seanboe/Onyx_PDB/README.md

# Onyx Power Distribution Board 

See the updated project in [Team Inspiration's Repository](https://github.com/InspirationRobotics/PowerDist).
