seanboe/Onyx_PDB/1.0/1.0-drl_map.dxf

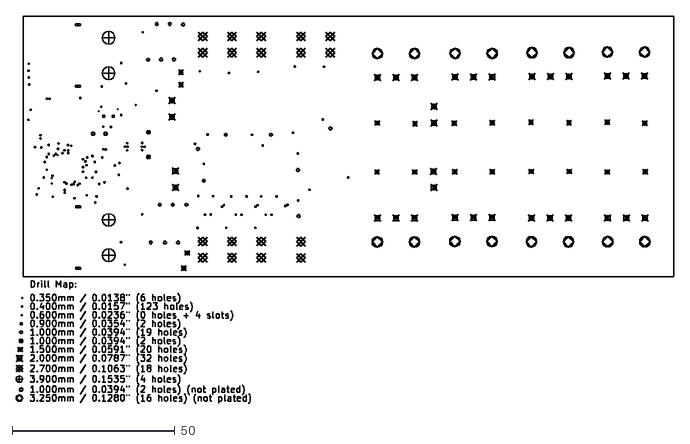
[picture p1: CAD file, 2023-02-26]
1.0/1.0-drl_map.dxf
202.1 x 118.9
