seanboe/Onyx_PDB/1.1/esc/hot_swap_3dmodels/BESC30-R3.step

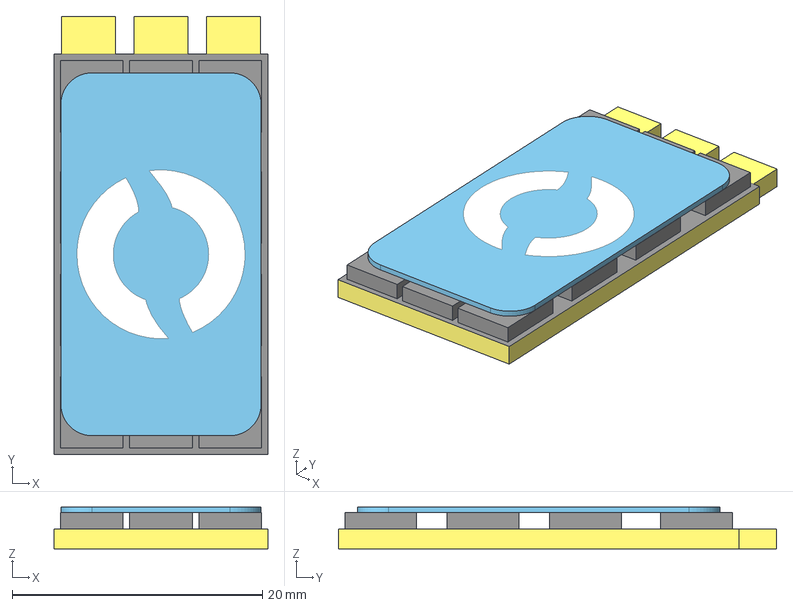
[picture p2: CAD file, 2023-02-10]
1.1/esc/hot_swap_3dmodels/BESC30-R3.step
17.1 x 35.0 x 3.35 mm
BASICESC-G-PCB-X1
BASICESC-E-MOSFET x 12
BASICESC-M-HEAT-SPREADER-X1
