seanboe/Onyx_PDB/1.1/main/gerbers/1.0-drl_map.dxf

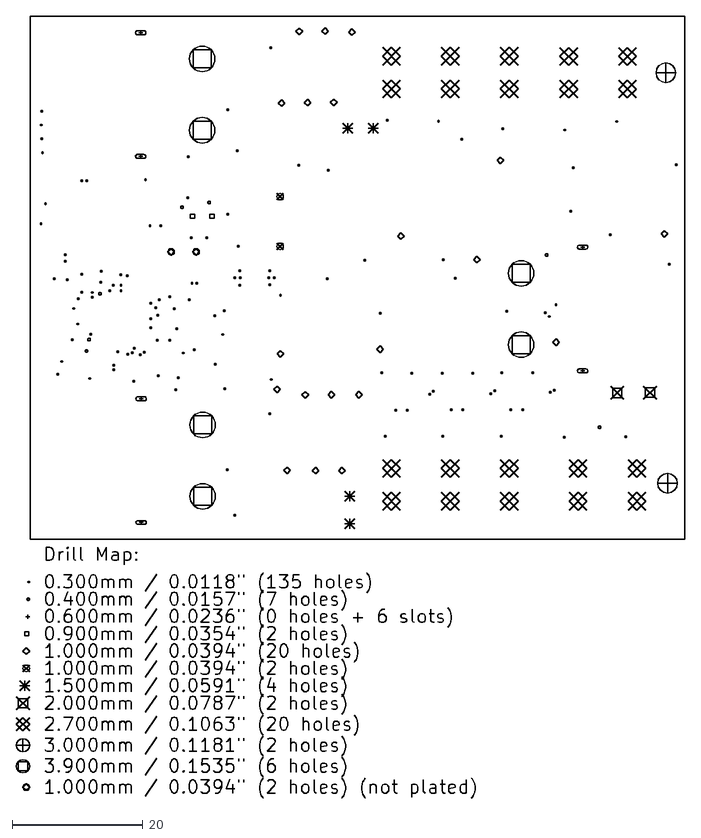
[picture p3: CAD file, 2023-06-17]
1.1/main/gerbers/1.0-drl_map.dxf
102.1 x 119.5
