seanboe/Onyx_PDB/mosfet_breakout_1.0/gerbers/mosfet_breakout_1.0-drl_map.dxf

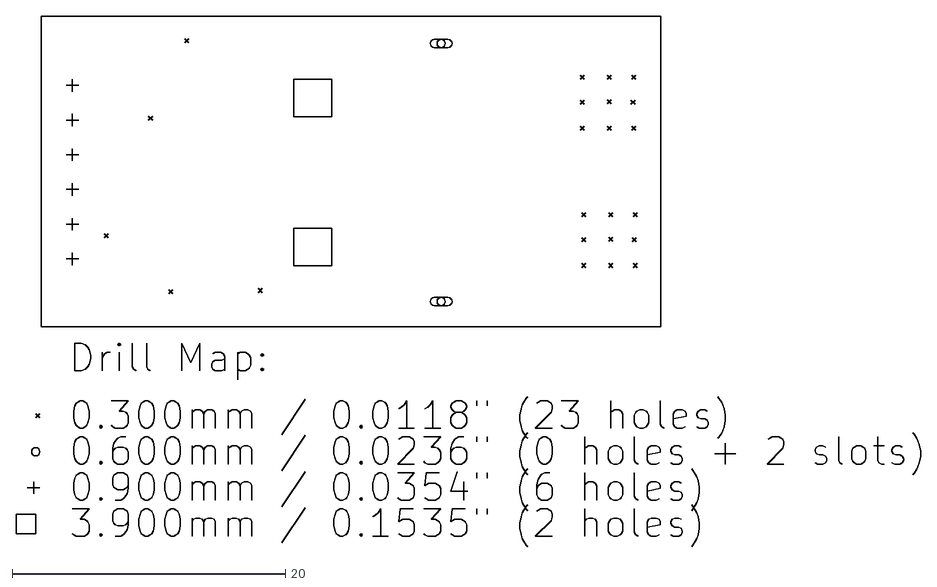
[picture p5: CAD file, 2023-06-17]
mosfet_breakout_1.0/gerbers/mosfet_breakout_1.0-drl_map.dxf
66.2 x 38.8
