seanboe/Onyx_PDB/1.1/main/1.0.kicad_pcb

## KiCad design 1.1/main/1.0.kicad_pcb (2023-06-17)

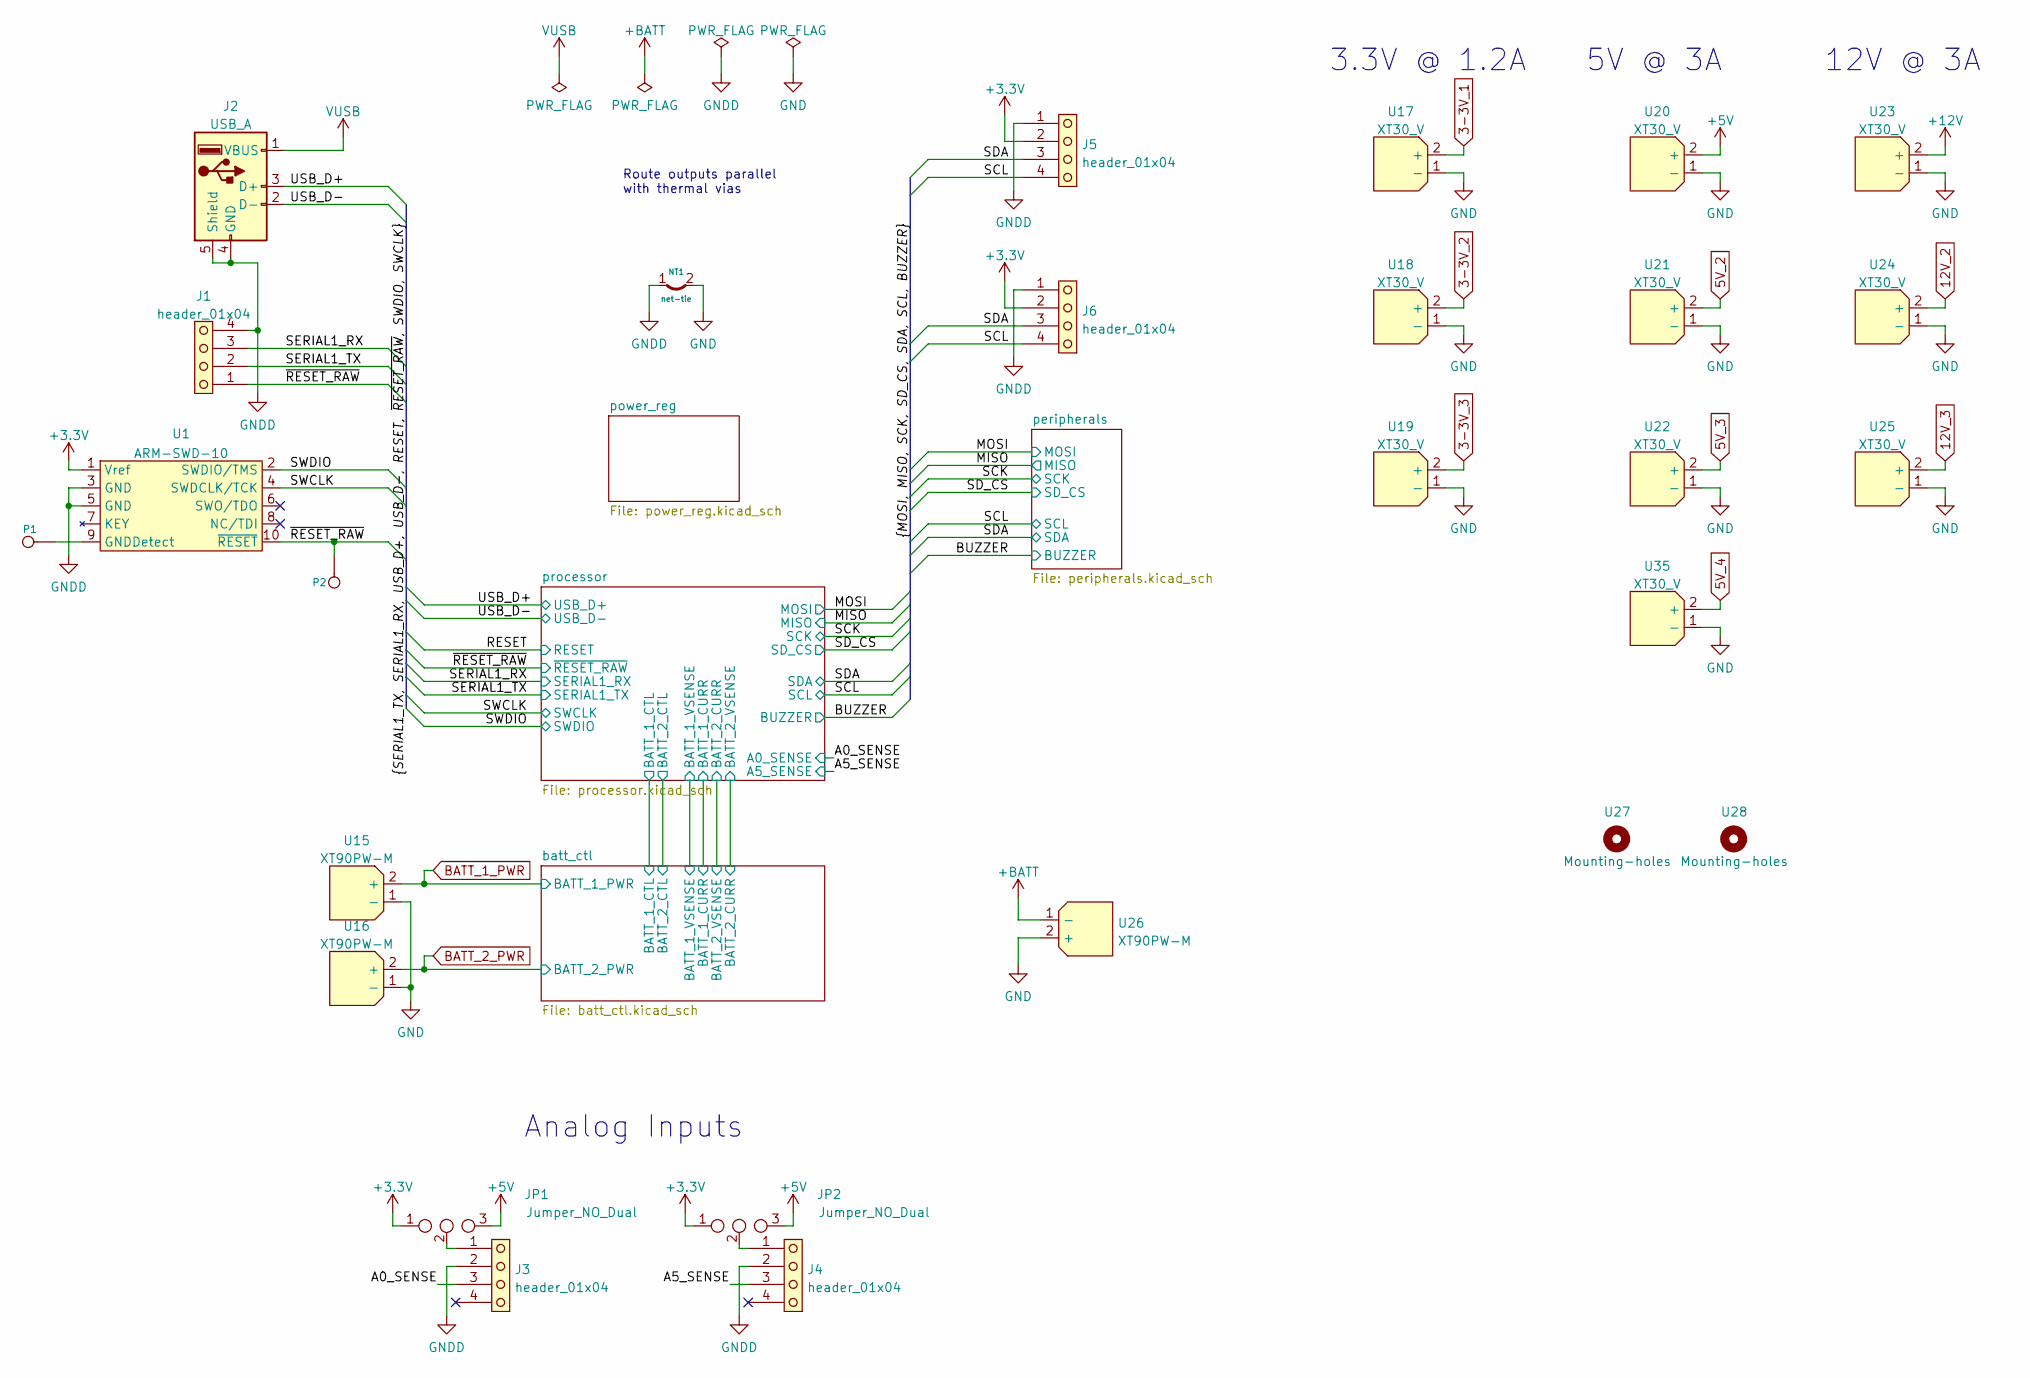
[picture p6: schematic 1.0.kicad_sch, Onyx Unified Power Control Board]

Parts:
J1: header_01x04; Stemma_QT_V
J2: USB_A; amphenol_micro_usb_no_flange_10118192
J3, J4, J5, J6: header_01x04; Stemma_QT_2
JP1, JP2: Jumper_NO_Dual; SolderJumper-3_P1.3mm_Open_RoundedPad1.0x1.5mm_NumberLabels
NT1: net-tie; NetTie-2_SMD_Pad2.0mm
P1, P2: CONN_1; header_01x01_tht
U1: ARM-SWD-10
U15, U16, U26: XT90PW-M; AMASS_XT90PW-M_Horizontal
U17, U18, U19, U20, U21, U22, U23, U24, U25, U35: XT30_V; AMASS_XT30U-F_1x02_P5.0mm_Vertical
U27, U28: Mounting-holes; plated_hole_3.0x3.6mm

Connections:
3-3V_1: U17.2 (+); also elsewhere on the board
3-3V_2: U18.2 (+); also elsewhere on the board
3-3V_3: U19.2 (+); also elsewhere on the board
5V_2: U21.2 (+); also elsewhere on the board
5V_3: U22.2 (+); also elsewhere on the board
12V_2: U24.2 (+); also elsewhere on the board
12V_3: U25.2 (+); also elsewhere on the board
+3V3: J5.2, J6.2, JP1.1, JP2.1, U1.1 (Vref); also elsewhere on the board
+5V: JP1.3, JP2.3, U20.2 (+); also elsewhere on the board
+12V: U23.2 (+); also elsewhere on the board
+BATT: U26.1 (-); also elsewhere on the board
/A0_SENSE: J3.3; also elsewhere on the board
/A5_SENSE: J4.3; also elsewhere on the board
/SCL: J5.4, J6.4; also elsewhere on the board
/SDA: J5.3, J6.3; also elsewhere on the board
/SERIAL1_RX: J1.3; also elsewhere on the board
/SERIAL1_TX: J1.2; also elsewhere on the board
/SWCLK: U1.4 (SWDCLK/TCK); also elsewhere on the board
/SWDIO: U1.2 (SWDIO/TMS); also elsewhere on the board
/USB_D+: J2.3 (D+); also elsewhere on the board
/USB_D-: J2.2 (D-); also elsewhere on the board
/~RESET_RAW: J1.1, P2.1, U1.10 (~RESET); also elsewhere on the board
BATT_1_PWR: U15.2 (+); also elsewhere on the board
BATT_2_PWR: U16.2 (+); also elsewhere on the board
GND: NT1.2, U15.1 (-), U16.1 (-), U17.1 (-), U18.1 (-), U19.1 (-), U20.1 (-), U21.1 (-), U22.1 (-), U23.1 (-), U24.1 (-), U25.1 (-), U26.2 (+), U35.1 (-); also elsewhere on the board
GNDD: J1.4, J2.4 (GND), J2.5 (Shield), J3.2, J4.2, J5.1, J6.1, NT1.1, U1.3 (GND), U1.5 (GND); also elsewhere on the board
unnamed: J3.1, JP1.2
unnamed: J4.1, JP2.2
unnamed: P1.1, U1.9 (GNDDetect)
VUSB: J2.1 (VBUS); also elsewhere on the board

Notes on the sheet:
12V @ 3A
Analog Inputs
Route outputs parallel with thermal vias
3.3V @ 1.2A
5V @ 3A

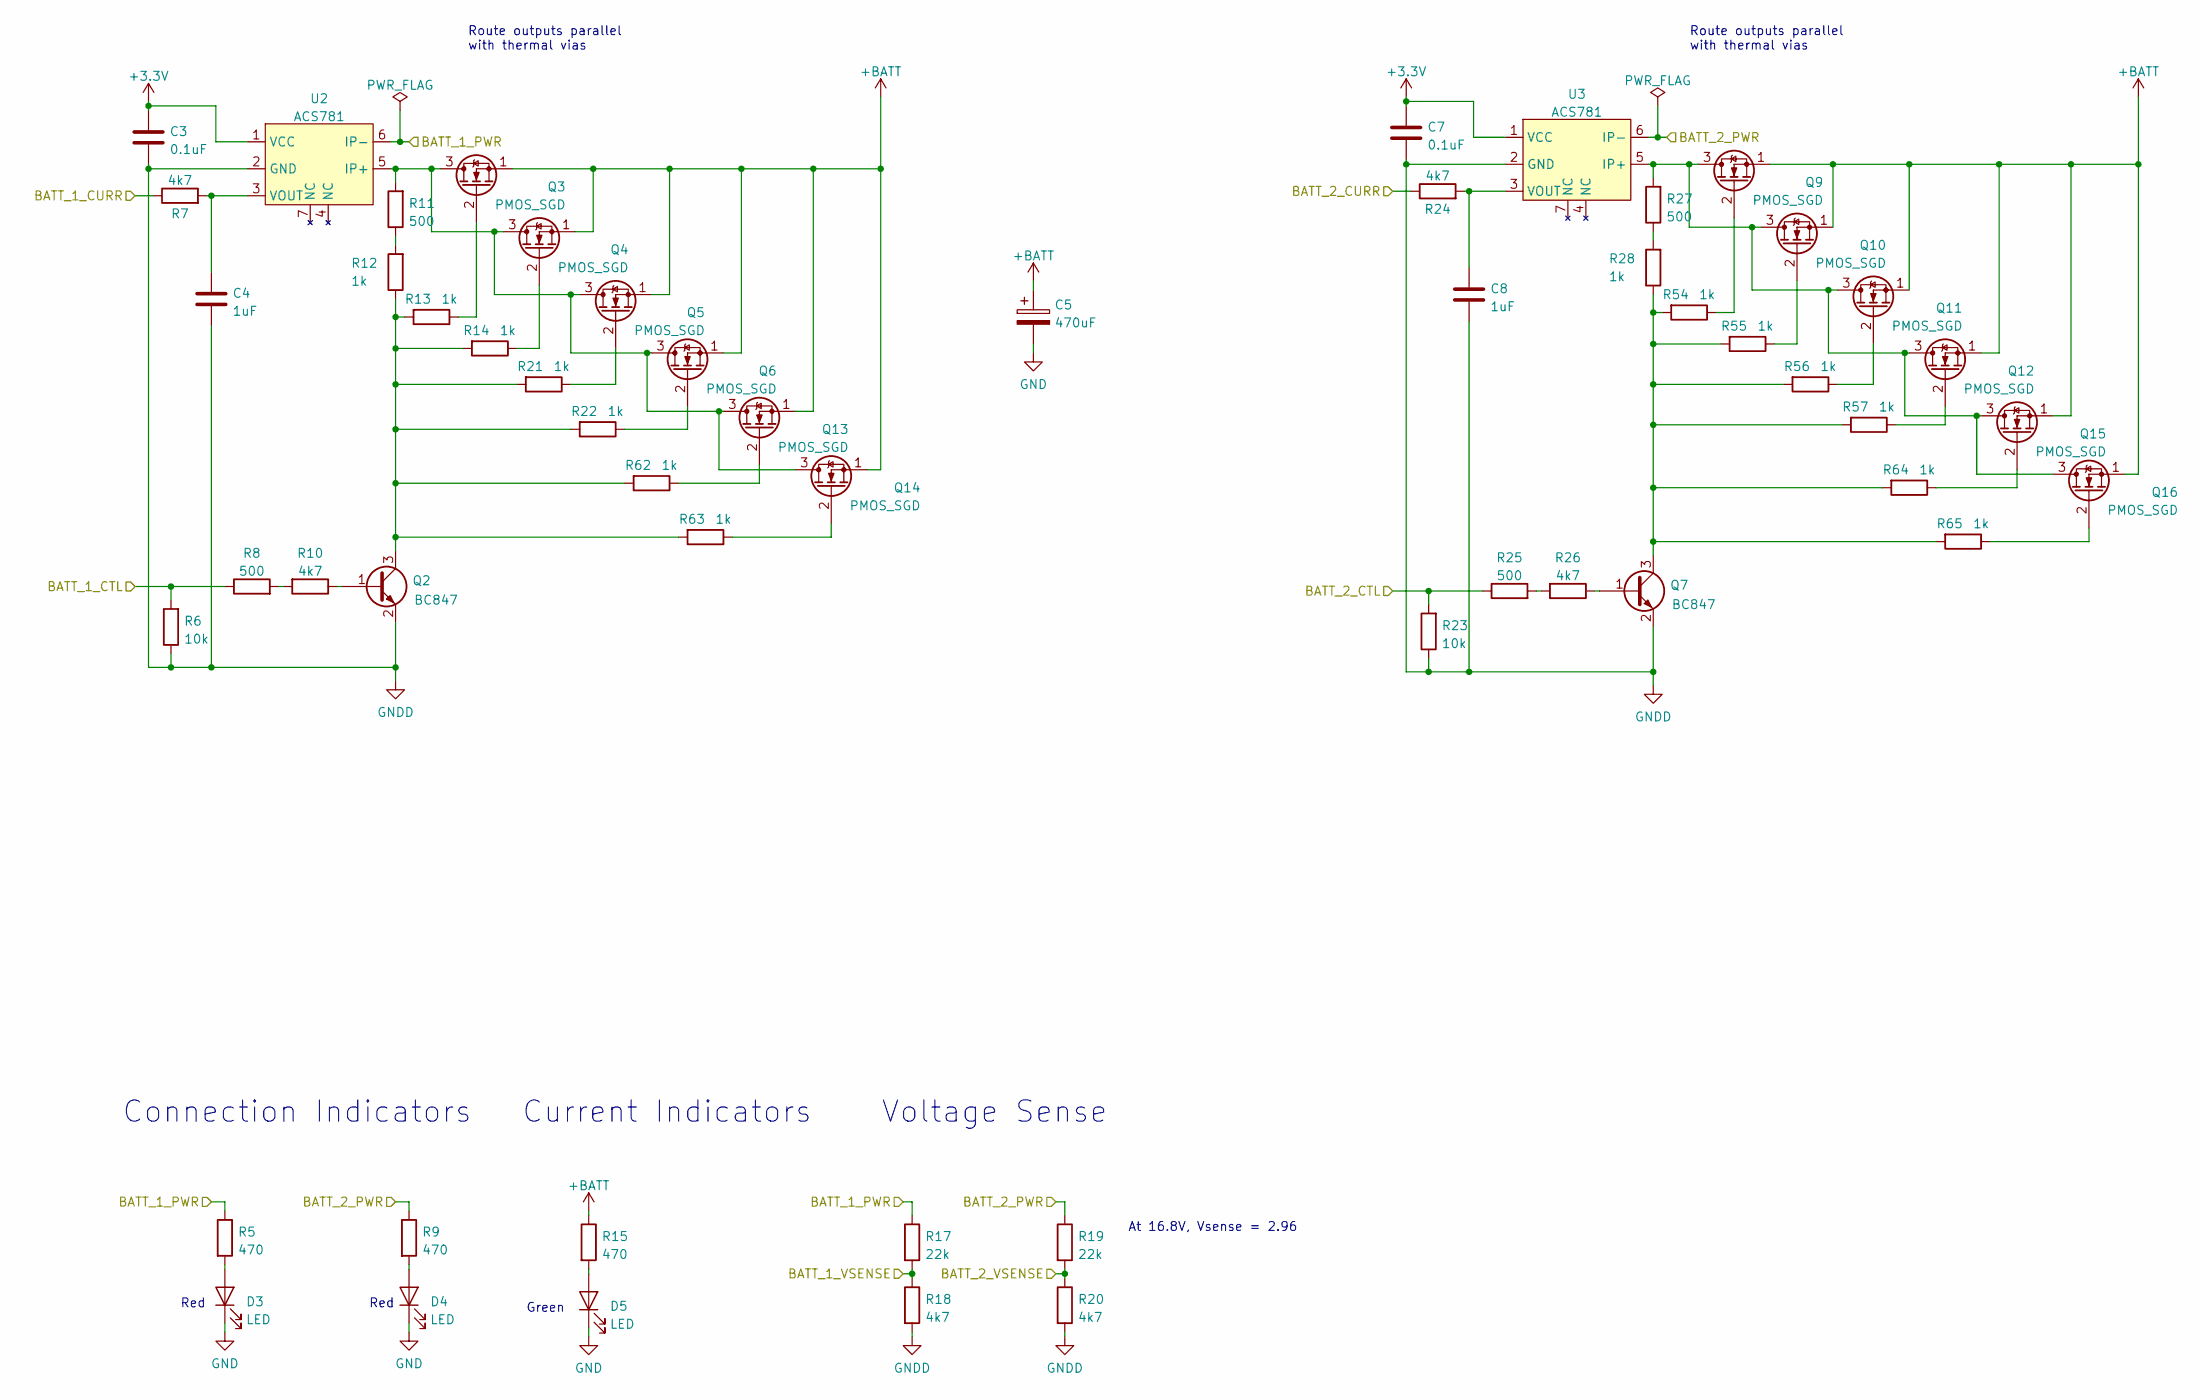
[picture p7: schematic batt_ctl.kicad_sch]

Parts:
C3, C7: 0.1uF; C_1608_603_B
C4, C8: 1uF; C_1608_603_B
C5: 470uF; THT_470uF_Cap
D3, D4, D5: LED; D_0603
Q2, Q7: BC847; SOT-23
Q3, Q4, Q5, Q6, Q9, Q10, Q11, Q12, Q13, Q14, Q15, Q16: PMOS_SGD; VDFN-8
R5, R9, R15: 470; R_1608_603_B
R6, R23: 10k; R_1608_603_B
R7, R10, R18, R20, R24, R26: 4k7; R_1608_603_B
R8, R11, R25, R27: 500; R_2012_805_B
R12, R13, R14, R21, R22, R28, R54, R55, R56, R57, R62, R63, R64, R65: 1k; R_1608_603_B
R17, R19: 22k; R_1608_603_B
U2, U3: ACS781; 7-LR-PSOF

Connections:
+3V3: C3.2, C7.2, U2.1 (VCC), U3.1 (VCC); also elsewhere on the board
+BATT: C5.1, Q3.1 (S), Q4.1 (S), Q5.1 (S), Q6.1 (S), Q9.1 (S), Q10.1 (S), Q11.1 (S), Q12.1 (S), Q13.1 (S), Q14.1 (S), Q15.1 (S), Q16.1 (S), R15.1; also elsewhere on the board
/batt_ctl/BATT_1_CTL: R6.2, R8.1; also elsewhere on the board
/batt_ctl/BATT_1_CURR: R7.1; also elsewhere on the board
/batt_ctl/BATT_1_VSENSE: R17.2, R18.1; also elsewhere on the board
/batt_ctl/BATT_2_CTL: R23.2, R25.1; also elsewhere on the board
/batt_ctl/BATT_2_CURR: R24.1; also elsewhere on the board
/batt_ctl/BATT_2_VSENSE: R19.2, R20.1; also elsewhere on the board
BATT_1_PWR: R5.1, R17.1, U2.6 (IP-); also elsewhere on the board
BATT_2_PWR: R9.1, R19.1, U3.6 (IP-); also elsewhere on the board
GND: C5.2, D3.1 (K), D4.1 (K), D5.1 (K); also elsewhere on the board
GNDD: C3.1, C4.1, C7.1, C8.1, Q2.2 (E), Q7.2 (E), R6.1, R18.2, R20.2, R23.1, U2.2 (GND), U3.2 (GND); also elsewhere on the board
unnamed: C4.2, R7.2, U2.3 (VOUT)
unnamed: C8.2, R24.2, U3.3 (VOUT)
unnamed: D3.2 (A), R5.2
unnamed: D4.2 (A), R9.2
unnamed: D5.2 (A), R15.2
unnamed: Q2.1 (B), R10.1
unnamed: Q2.3 (C), R12.1, R13.2, R14.2, R21.2, R22.2, R62.2, R63.2
unnamed: Q3.2 (G), R13.1
unnamed: Q4.2 (G), R14.1
unnamed: Q5.2 (G), R21.1
unnamed: Q6.2 (G), R22.1
unnamed: Q7.1 (B), R26.1
unnamed: Q7.3 (C), R28.1, R54.2, R55.2, R56.2, R57.2, R64.2, R65.2
unnamed: Q9.2 (G), R54.1
unnamed: Q10.2 (G), R55.1
unnamed: Q9.3 (D), Q10.3 (D), Q11.3 (D), Q12.3 (D), Q15.3 (D), Q16.3 (D), R27.2, U3.5 (IP+)
unnamed: Q11.2 (G), R56.1
unnamed: Q12.2 (G), R57.1
unnamed: Q13.2 (G), R62.1
unnamed: Q3.3 (D), Q4.3 (D), Q5.3 (D), Q6.3 (D), Q13.3 (D), Q14.3 (D), R11.2, U2.5 (IP+)
unnamed: Q14.2 (G), R63.1
unnamed: Q15.2 (G), R64.1
unnamed: Q16.2 (G), R65.1
unnamed: R8.2, R10.2
unnamed: R11.1, R12.2
unnamed: R25.2, R26.2
unnamed: R27.1, R28.2

Notes on the sheet:
Connection Indicators
Red
Route outputs parallel with thermal vias
Voltage Sense
Green
Current Indicators
At 16.8V, Vsense = 2.96

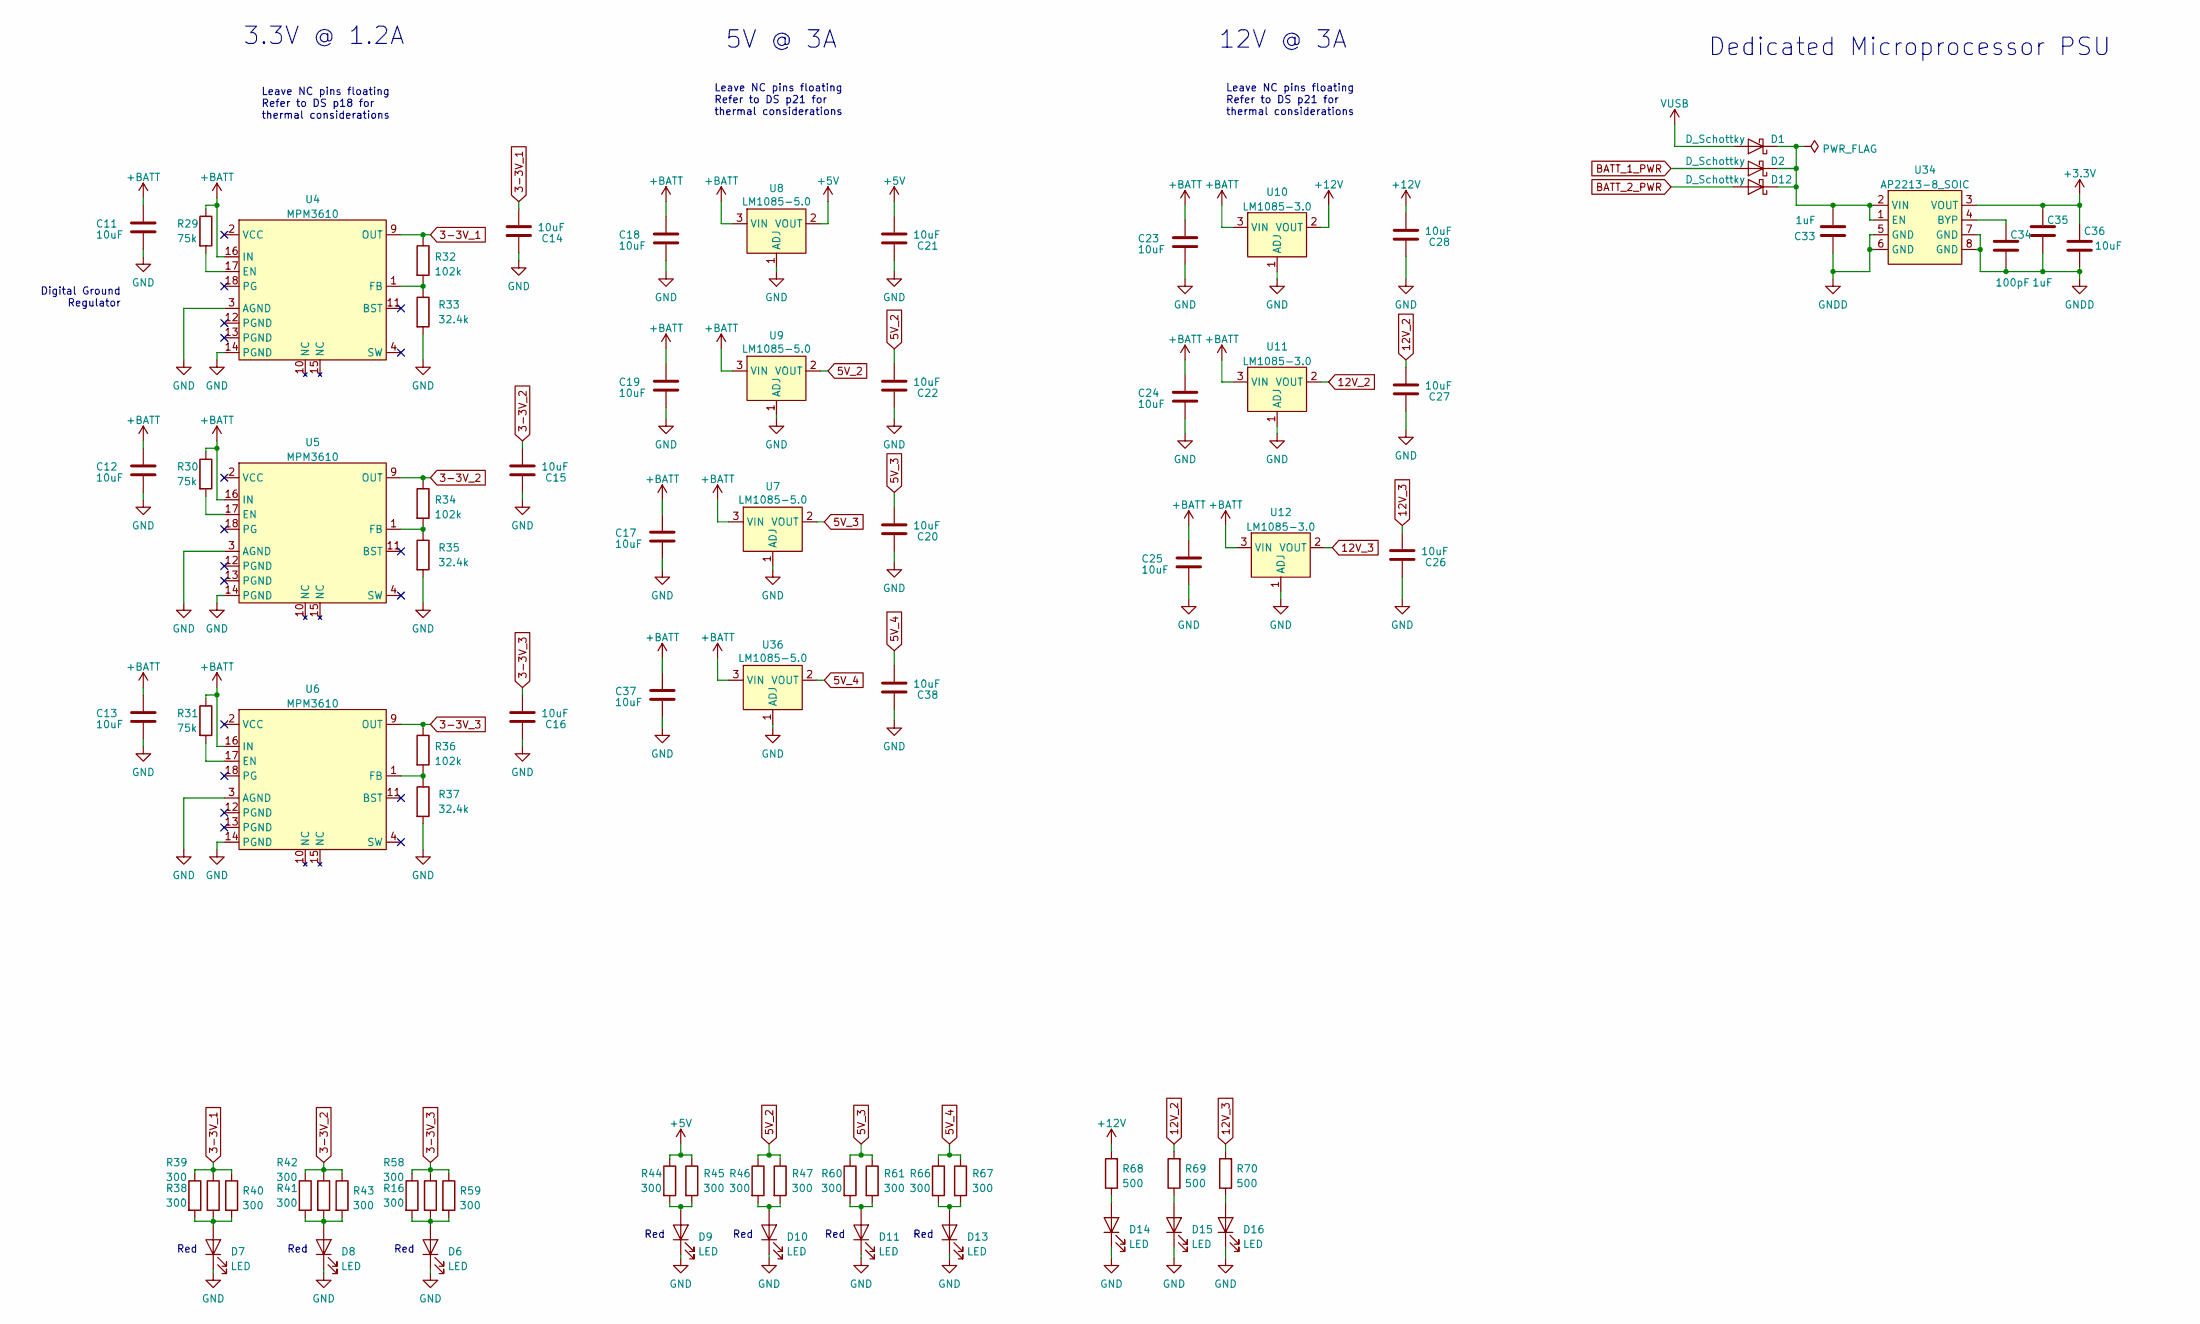
[picture p8: schematic power_reg.kicad_sch]

Parts:
C11, C12, C13, C17, C18, C19, C23, C24, C25, C37: 10uF; C_2012_805_B
C14, C15, C16, C20, C21, C22, C26, C27, C28, C36, C38: 10uF; C_1608_603_B
C33, C35: 1uF; C_1608_603_B; Part 0603YC105KAT2A
C34: 100pF; C_1608_603_B; Part GCG1885G1H101JA01D
D1, D2, D12: D_Schottky; D_SOD-123F; Part PMEG1030EH
D6, D7, D8, D9, D10, D11, D13, D14, D15, D16: LED; D_0603
R16, R38, R39, R40, R41, R42, R43, R44, R45, R46, R47, R58, R59, R60, R61, R66, R67: 300; R_1608_603_B
R29, R30, R31: 75k; R_1608_603_B
R32, R34, R36: 102k; R_1608_603_B
R33, R35, R37: 32.4k; R_1608_603_B
R68, R69, R70: 500; R_2012_805_B
U4, U5, U6: MPM3610; 20-PowerLQFN
U7, U8, U9, U36: LM1085-5.0; TO-263-3_TabPin2
U10, U11, U12: LM1085-3.0; TO-263-3_TabPin2
U34: AP2213-8_SOIC; SOIC-8_3.9x4.9mm_P1.27mm

Connections:
3-3V_1: C14.1, R32.1, R38.1, R39.1, R40.1, U4.9 (OUT); also elsewhere on the board
3-3V_2: C15.1, R34.1, R41.1, R42.1, R43.1, U5.9 (OUT); also elsewhere on the board
3-3V_3: C16.1, R16.1, R36.1, R58.1, R59.1, U6.9 (OUT); also elsewhere on the board
5V_2: C22.1, R46.1, R47.1, U9.2 (VOUT); also elsewhere on the board
5V_3: C20.1, R60.1, R61.1, U7.2 (VOUT); also elsewhere on the board
5V_4: C38.1, R66.1, R67.1, U36.2 (VOUT)
12V_2: C27.1, R69.2, U11.2 (VOUT); also elsewhere on the board
12V_3: C26.1, R70.2, U12.2 (VOUT); also elsewhere on the board
+3V3: C35.1, C36.1, U34.3 (VOUT); also elsewhere on the board
+5V: C21.1, R44.1, R45.1, U8.2 (VOUT); also elsewhere on the board
+12V: C28.1, R68.2, U10.2 (VOUT); also elsewhere on the board
+BATT: C11.1, C12.1, C13.1, C17.1, C18.1, C19.1, C23.1, C24.1, C25.1, C37.1, R29.1, R30.1, R31.1, U4.16 (IN), U5.16 (IN), U6.16 (IN), U7.3 (VIN), U8.3 (VIN), U9.3 (VIN), U10.3 (VIN), U11.3 (VIN), U12.3 (VIN), U36.3 (VIN); also elsewhere on the board
BATT_1_PWR: D2.2 (A); also elsewhere on the board
BATT_2_PWR: D12.2 (A); also elsewhere on the board
GND: C11.2, C12.2, C13.2, C14.2, C15.2, C16.2, C17.2, C18.2, C19.2, C20.2, C21.2, C22.2, C23.2, C24.2, C25.2, C26.2, C27.2, C28.2, C37.2, C38.2, D6.1 (K), D7.1 (K), D8.1 (K), D9.1 (K), D10.1 (K), D11.1 (K), D13.1 (K), D14.1 (K), D15.1 (K), D16.1 (K), R33.2, R35.2, R37.2, U4.3 (AGND), U4.14 (PGND), U5.3 (AGND), U5.14 (PGND), U6.3 (AGND), U6.14 (PGND), U7.1 (ADJ), U8.1 (ADJ), U9.1 (ADJ), U10.1 (ADJ), U11.1 (ADJ), U12.1 (ADJ), U36.1 (ADJ); also elsewhere on the board
GNDD: C33.1, C34.2, C35.2, C36.2, U34.5 (GND), U34.6 (GND), U34.7 (GND), U34.8 (GND); also elsewhere on the board
unnamed: C33.2, D1.1 (K), D2.1 (K), D12.1 (K), U34.1 (EN), U34.2 (VIN)
unnamed: C34.1, U34.4 (BYP)
unnamed: D6.2 (A), R16.2, R58.2, R59.2
unnamed: D7.2 (A), R38.2, R39.2, R40.2
unnamed: D8.2 (A), R41.2, R42.2, R43.2
unnamed: D9.2 (A), R44.2, R45.2
unnamed: D10.2 (A), R46.2, R47.2
unnamed: D11.2 (A), R60.2, R61.2
unnamed: D13.2 (A), R66.2, R67.2
unnamed: D14.2 (A), R68.1
unnamed: D15.2 (A), R69.1
unnamed: D16.2 (A), R70.1
unnamed: R29.2, U4.17 (EN)
unnamed: R30.2, U5.17 (EN)
unnamed: R31.2, U6.17 (EN)
unnamed: R32.2, R33.1, U4.1 (FB)
unnamed: R34.2, R35.1, U5.1 (FB)
unnamed: R36.2, R37.1, U6.1 (FB)
VUSB: D1.2 (A); also elsewhere on the board

Notes on the sheet:
Leave NC pins floating Refer to DS p21 for thermal considerations
Red
12V @ 3A
3.3V @ 1.2A
Digital Ground Regulator
5V @ 3A
Dedicated Microprocessor PSU
Leave NC pins floating Refer to DS p18 for thermal considerations

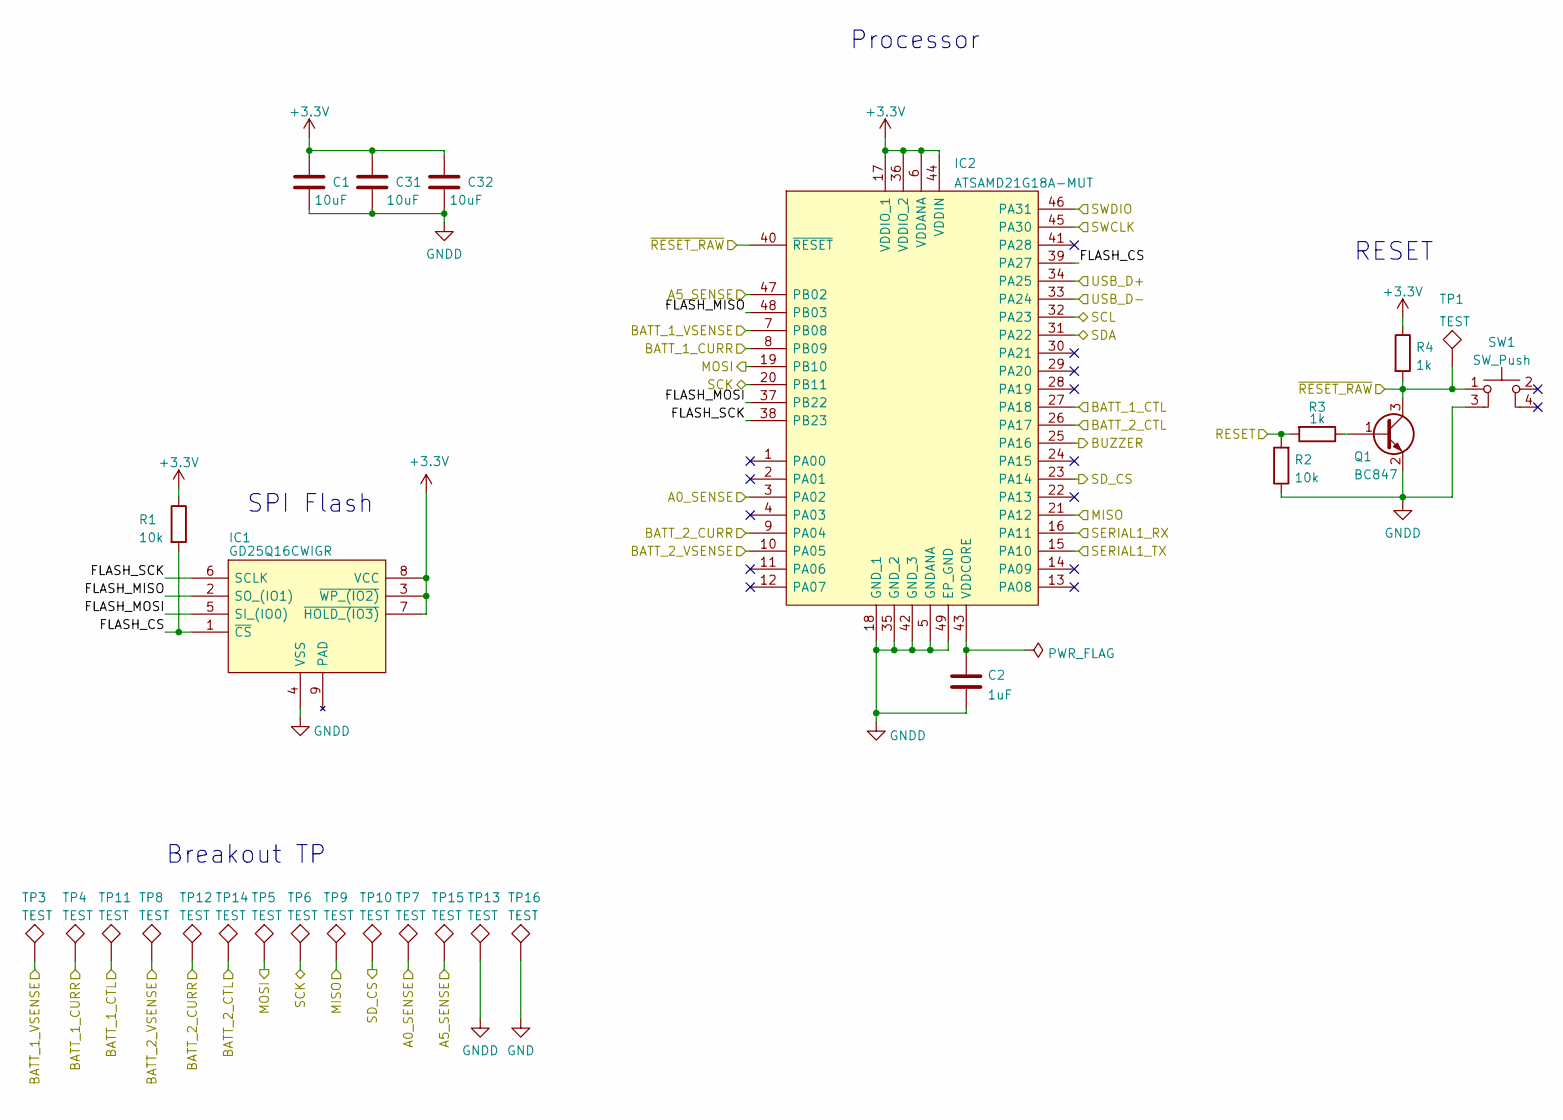
[picture p9: schematic processor.kicad_sch]

Parts:
C1, C31, C32: 10uF; C_1608_603_B
C2: 1uF; C_1608_603_B; Part 0603YC105KAT2A
IC1: GD25Q16CWIGR; SOIC-8_3.9x4.9mm_P1.27mm
IC2: ATSAMD21G18A-MUT; QFN50P700X700X90-49N-D
Q1: BC847; SOT-23
R1, R2: 10k; R_1608_603_B
R3, R4: 1k; R_1608_603_B
SW1: SW_Push; KMR243GLFG
TP1: TEST; test_point_1.0mm_square
TP3, TP4, TP5, TP6, TP7, TP8, TP9, TP10, TP11, TP12, TP13, TP14, TP15, TP16: TEST; test_point_2mm_square

Connections:
+3V3: C1.1, C31.1, C32.1, IC1.3 (~WP_(IO2)), IC1.7 (~HOLD_(IO3)), IC1.8 (VCC), IC2.6 (VDDANA), IC2.17 (VDDIO_1), IC2.36 (VDDIO_2), IC2.44 (VDDIN), R1.1, R4.1; also elsewhere on the board
/A0_SENSE: IC2.3 (PA02), TP7.1; also elsewhere on the board
/A5_SENSE: IC2.47 (PB02), TP15.1; also elsewhere on the board
/BUZZER: IC2.25 (PA16); also elsewhere on the board
/MISO: IC2.21 (PA12), TP9.1; also elsewhere on the board
/MOSI: IC2.19 (PB10), TP5.1; also elsewhere on the board
/RESET: R2.2, R3.2
/SCK: IC2.20 (PB11), TP6.1; also elsewhere on the board
/SCL: IC2.32 (PA23); also elsewhere on the board
/SDA: IC2.31 (PA22); also elsewhere on the board
/SD_CS: IC2.23 (PA14), TP10.1; also elsewhere on the board
/SERIAL1_RX: IC2.16 (PA11); also elsewhere on the board
/SERIAL1_TX: IC2.15 (PA10); also elsewhere on the board
/SWCLK: IC2.45 (PA30); also elsewhere on the board
/SWDIO: IC2.46 (PA31); also elsewhere on the board
/USB_D+: IC2.34 (PA25); also elsewhere on the board
/USB_D-: IC2.33 (PA24); also elsewhere on the board
/batt_ctl/BATT_1_CTL: IC2.27 (PA18), TP11.1; also elsewhere on the board
/batt_ctl/BATT_1_CURR: IC2.8 (PB09), TP4.1; also elsewhere on the board
/batt_ctl/BATT_1_VSENSE: IC2.7 (PB08), TP3.1; also elsewhere on the board
/batt_ctl/BATT_2_CTL: IC2.26 (PA17), TP14.1; also elsewhere on the board
/batt_ctl/BATT_2_CURR: IC2.10 (PA05), TP8.1; also elsewhere on the board
/batt_ctl/BATT_2_VSENSE: IC2.9 (PA04), TP12.1; also elsewhere on the board
/processor/FLASH_CS: IC1.1 (~CS), IC2.39 (PA27), R1.2
/processor/FLASH_MISO: IC1.2 (SO_(IO1)), IC2.48 (PB03)
/processor/FLASH_MOSI: IC1.5 (SI_(IO0)), IC2.37 (PB22)
/processor/FLASH_SCK: IC1.6 (SCLK), IC2.38 (PB23)
/~RESET_RAW: IC2.40 (~RESET), Q1.3 (C), R4.2, SW1.1, TP1.1; also elsewhere on the board
GND: TP16.1; also elsewhere on the board
GNDD: C1.2, C2.2, C31.2, C32.2, IC1.4 (VSS), IC2.5 (GNDANA), IC2.18 (GND_1), IC2.35 (GND_2), IC2.42 (GND_3), IC2.49 (EP_GND), Q1.2 (E), R2.1, SW1.3, TP13.1; also elsewhere on the board
unnamed: C2.1, IC2.43 (VDDCORE)
unnamed: Q1.1 (B), R3.1

Notes on the sheet:
SPI Flash
RESET
Breakout TP
Processor

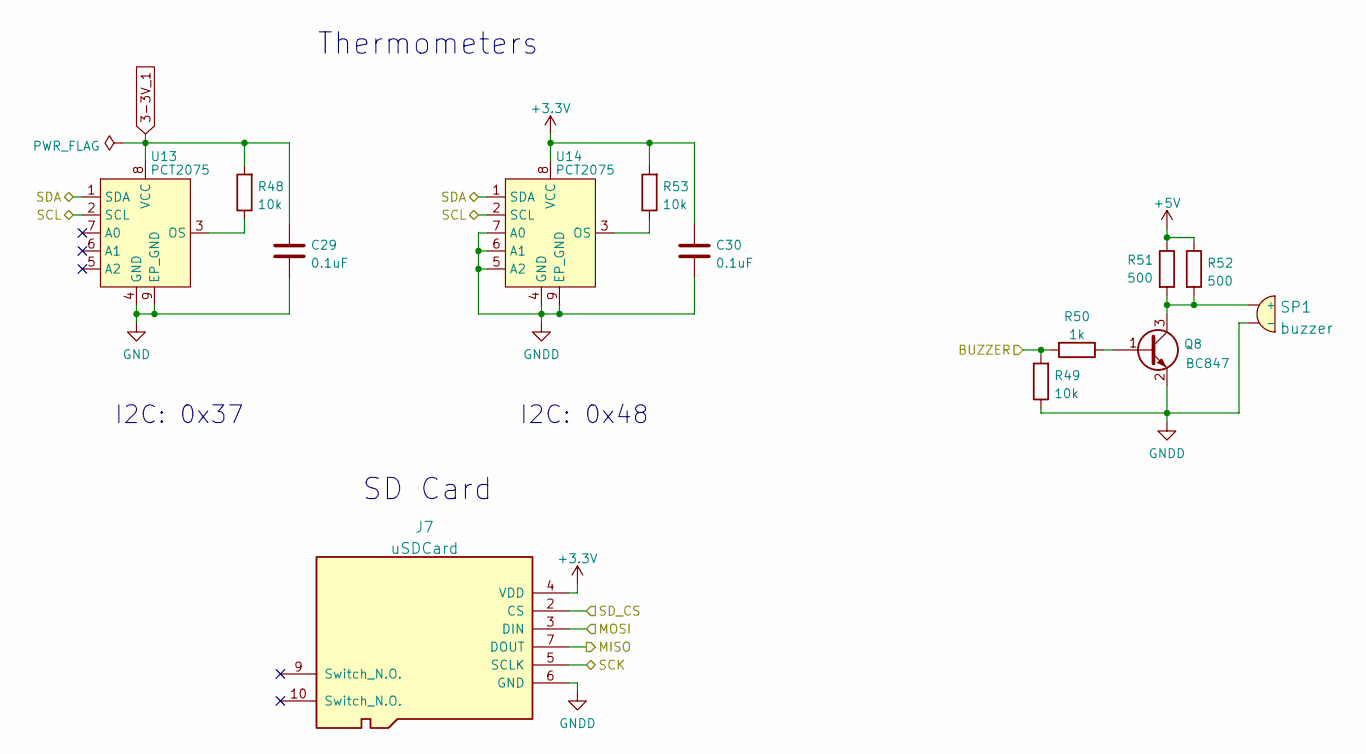
[picture p10: schematic peripherals.kicad_sch]

Parts:
C29, C30: 0.1uF; C_1608_603_B
J7: uSDCard; uSDCard_SD_503182_011
Q8: BC847; SOT-23
R48, R49, R53: 10k; R_1608_603_B
R50: 1k; R_1608_603_B
R51, R52: 500; R_2012_805_B
SP1: buzzer; 13-9mm_Buzzer
U13, U14: PCT2075; PCT2075TP_147

Connections:
3-3V_1: C29.2, R48.2, U13.8 (VCC); also elsewhere on the board
+3V3: C30.2, J7.4 (VDD), R53.2, U14.8 (VCC); also elsewhere on the board
+5V: R51.1, R52.1; also elsewhere on the board
/BUZZER: R49.2, R50.2; also elsewhere on the board
/MISO: J7.7 (DOUT); also elsewhere on the board
/MOSI: J7.3 (DIN); also elsewhere on the board
/SCK: J7.5 (SCLK); also elsewhere on the board
/SCL: U13.2 (SCL), U14.2 (SCL); also elsewhere on the board
/SDA: U13.1 (SDA), U14.1 (SDA); also elsewhere on the board
/SD_CS: J7.2 (CS); also elsewhere on the board
GND: C29.1, U13.4 (GND), U13.9 (EP_GND); also elsewhere on the board
GNDD: C30.1, J7.6 (GND), Q8.2 (E), R49.1, SP1.2 (-), U14.4 (GND), U14.5 (A2), U14.6 (A1), U14.7 (A0), U14.9 (EP_GND); also elsewhere on the board
unnamed: Q8.1 (B), R50.1
unnamed: Q8.3 (C), R51.2, R52.2, SP1.1 (+)
unnamed: R48.1, U13.3 (OS)
unnamed: R53.1, U14.3 (OS)

Notes on the sheet:
I2C: 0x48
SD Card
I2C: 0x37
Thermometers

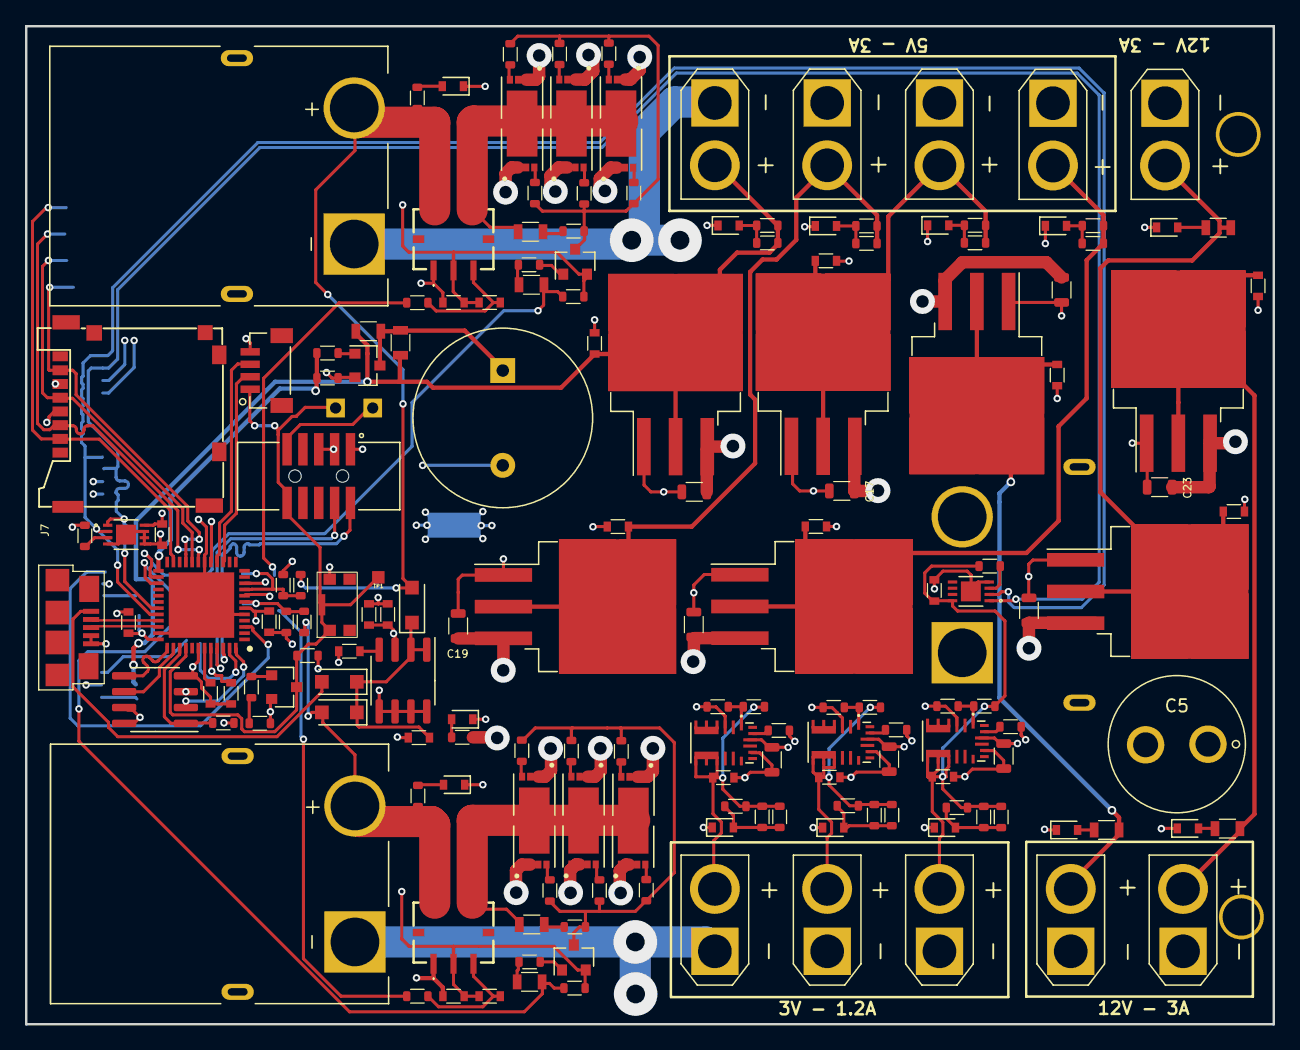
[picture p11: board 1.0.kicad_pcb from above]

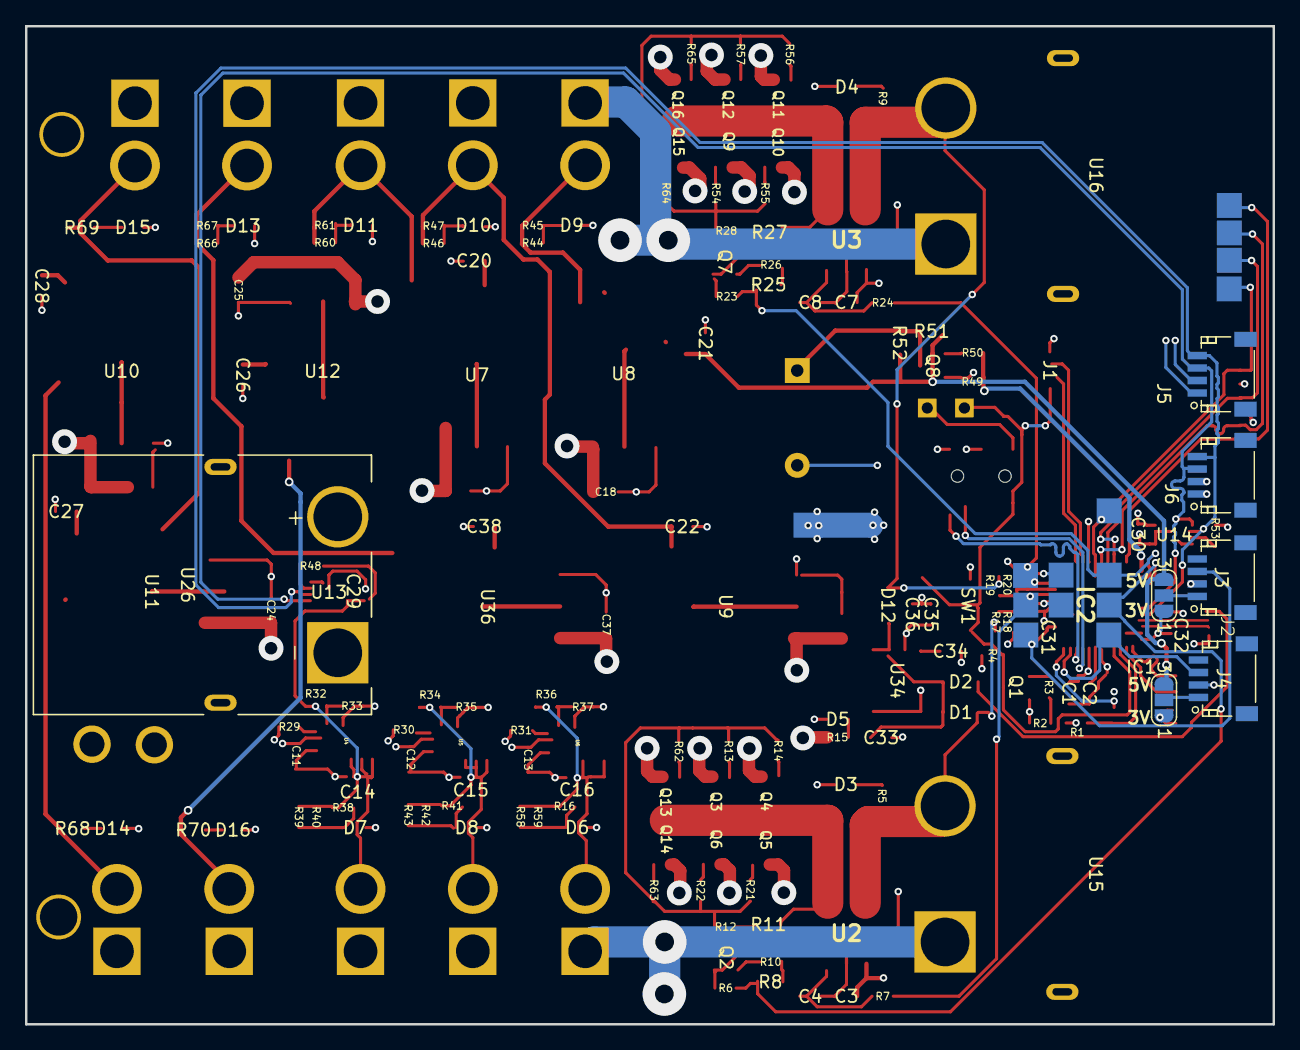
[picture p12: board 1.0.kicad_pcb from below]

Board: 4 copper layers, 100.0 x 80.0 mm, 199 parts (22 on the bottom side), 98 nets.
