seanboe/Onyx_PDB/mosfet_breakout_1.0/mosfet_breakout_1.0.kicad_pcb

## KiCad design mosfet_breakout_1.0/mosfet_breakout_1.0.kicad_pcb (2023-06-17)

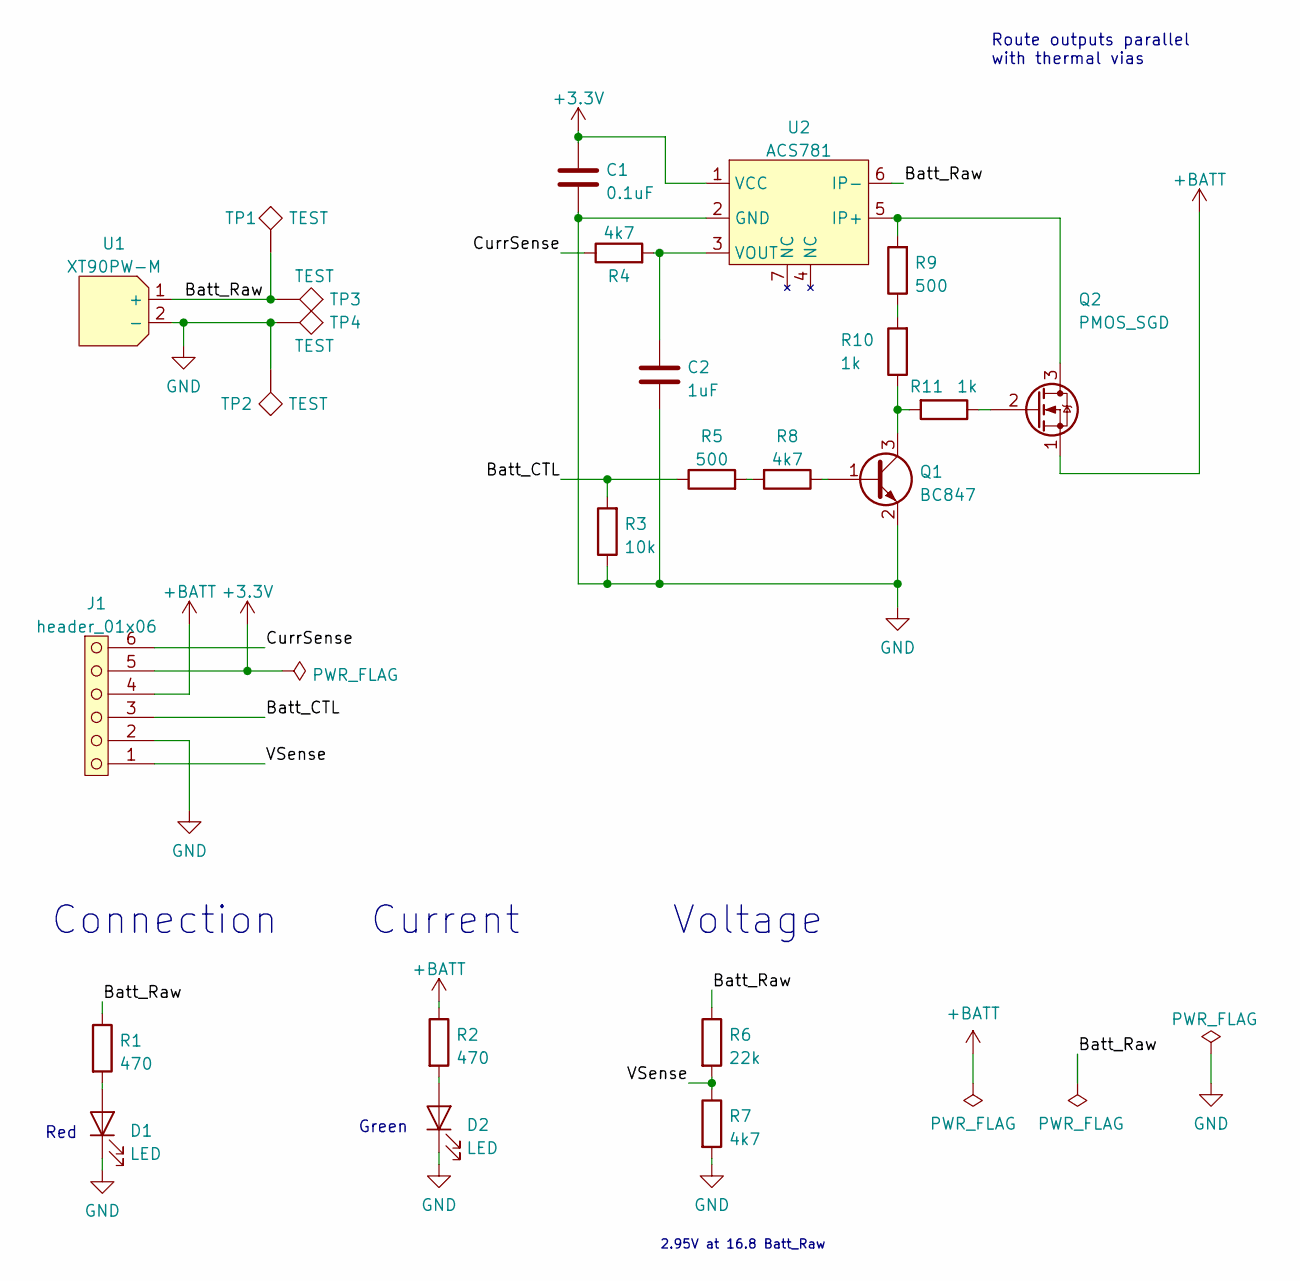
[picture p13: schematic mosfet_breakout_1.0.kicad_sch]

Parts:
C1: 0.1uF; C_1608_603_B
C2: 1uF; C_1608_603_B
D1, D2: LED; R_1608_603_B
J1: header_01x06; header_01x06_pitch2.54_tht
Q1: BC847; SOT-23
Q2: PMOS_SGD; VDFN-8
R1, R2: 470; R_1608_603_B
R3: 10k; R_1608_603_B
R4, R7, R8: 4k7; R_1608_603_B
R5, R9: 500; R_2012_805_B
R6: 22k; R_1608_603_B
R10, R11: 1k; R_1608_603_B
TP1, TP2, TP3, TP4: TEST; test_point_5mm_square
U1: XT90PW-M; AMASS_XT90PW-M_Horizontal
U2: ACS781; 7-LR-PSOF

Connections:
+3V3: C1.2, J1.5, U2.1 (VCC)
+BATT: J1.4, Q2.1 (S), R2.1
/Batt_CTL: J1.3, R3.2, R5.1
/Batt_Raw: R1.1, R6.1, TP1.1, TP3.1, U1.1 (+), U2.6 (IP-)
/CurrSense: J1.6, R4.1
/VSense: J1.1, R6.2, R7.1
GND: C1.1, C2.1, D1.1 (K), D2.1 (K), J1.2, Q1.2 (E), R3.1, R7.2, TP2.1, TP4.1, U1.2 (-), U2.2 (GND)
unnamed: C2.2, R4.2, U2.3 (VOUT)
unnamed: D1.2 (A), R1.2
unnamed: D2.2 (A), R2.2
unnamed: Q1.1 (B), R8.1
unnamed: Q1.3 (C), R10.1, R11.2
unnamed: Q2.2 (G), R11.1
unnamed: Q2.3 (D), R9.2, U2.5 (IP+)
unnamed: R5.2, R8.2
unnamed: R9.1, R10.2

Notes on the sheet:
2.95V at 16.8 Batt_Raw
Red
Current
Route outputs parallel with thermal vias
Connection
Green
Voltage

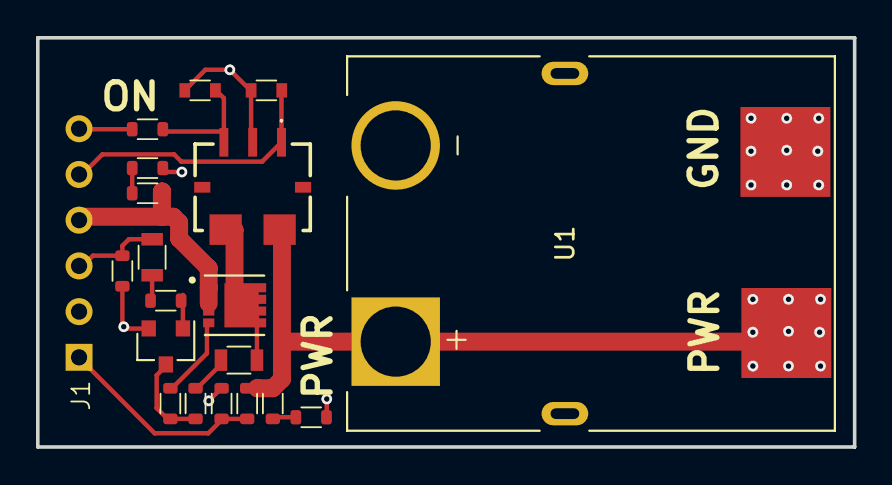
[picture p14: board mosfet_breakout_1.0.kicad_pcb from above]

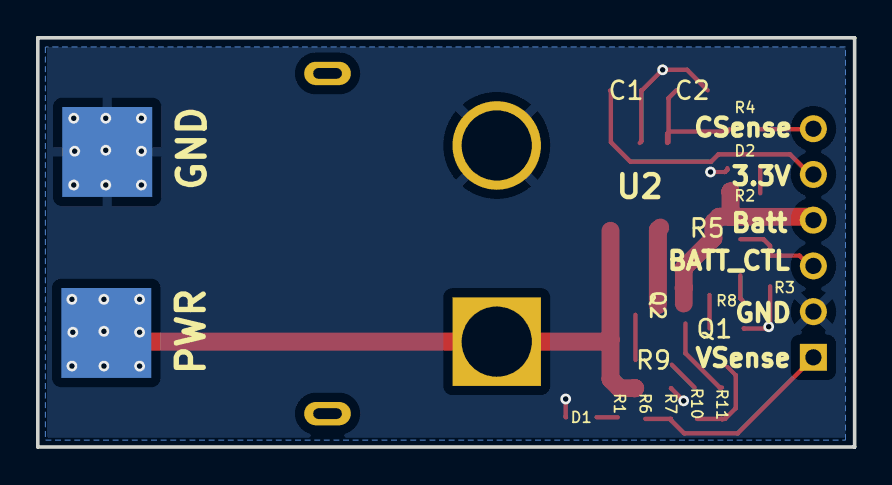
[picture p15: board mosfet_breakout_1.0.kicad_pcb from below]

Board: 2 copper layers, 45.4 x 22.7 mm, 24 parts (2 on the bottom side), 16 nets.
