seanboe/Onyx_PDB/1.2/esc/esc.kicad_pcb

## KiCad design 1.2/esc/esc.kicad_pcb (2023-06-17)

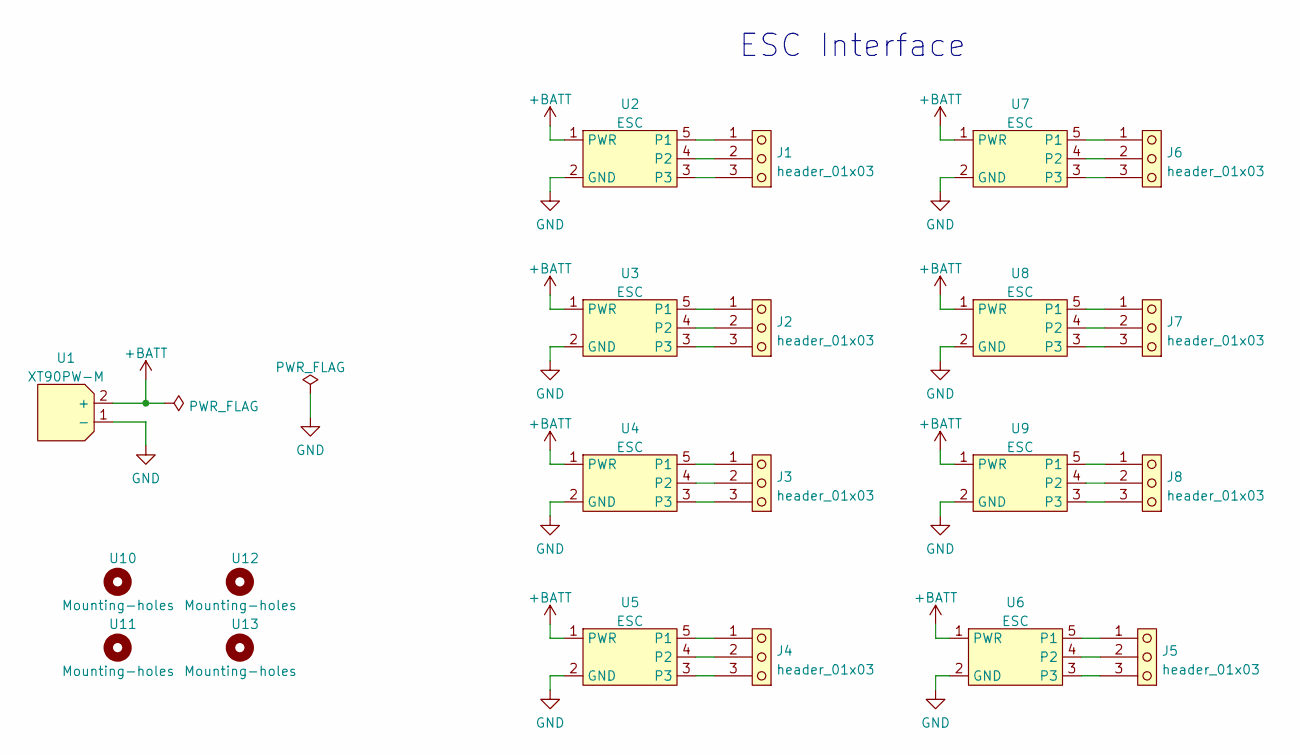
[picture p16: schematic esc.kicad_sch, Onyx Unified ESC board]

Parts:
J1, J2, J3, J4, J5, J6, J7, J8: header_01x03; MegaF_RAH_Single_3x5.7mm
U1: XT90PW-M; AMASS_XT90PW-M_Horizontal
U2, U3, U4, U5, U6, U7, U8, U9: ESC; esc
U10, U11, U12, U13: Mounting-holes; plated_hole_3.0x3.6mm

Connections:
+BATT: U1.2 (+), U2.1 (PWR), U3.1 (PWR), U4.1 (PWR), U5.1 (PWR), U6.1 (PWR), U7.1 (PWR), U8.1 (PWR), U9.1 (PWR)
GND: U1.1 (-), U2.2 (GND), U3.2 (GND), U4.2 (GND), U5.2 (GND), U6.2 (GND), U7.2 (GND), U8.2 (GND), U9.2 (GND)
unnamed: J1.1, U2.5 (P1)
unnamed: J1.2, U2.4 (P2)
unnamed: J1.3, U2.3
unnamed: J2.1, U3.5 (P1)
unnamed: J2.2, U3.4 (P2)
unnamed: J2.3, U3.3
unnamed: J3.1, U4.5 (P1)
unnamed: J3.2, U4.4 (P2)
unnamed: J3.3, U4.3
unnamed: J4.1, U5.5 (P1)
unnamed: J4.2, U5.4 (P2)
unnamed: J4.3, U5.3
unnamed: J5.1, U6.5 (P1)
unnamed: J5.2, U6.4 (P2)
unnamed: J5.3, U6.3
unnamed: J6.1, U7.5 (P1)
unnamed: J6.2, U7.4 (P2)
unnamed: J6.3, U7.3
unnamed: J7.1, U8.5 (P1)
unnamed: J7.2, U8.4 (P2)
unnamed: J7.3, U8.3
unnamed: J8.1, U9.5 (P1)
unnamed: J8.2, U9.4 (P2)
unnamed: J8.3, U9.3

Notes on the sheet:
ESC Interface

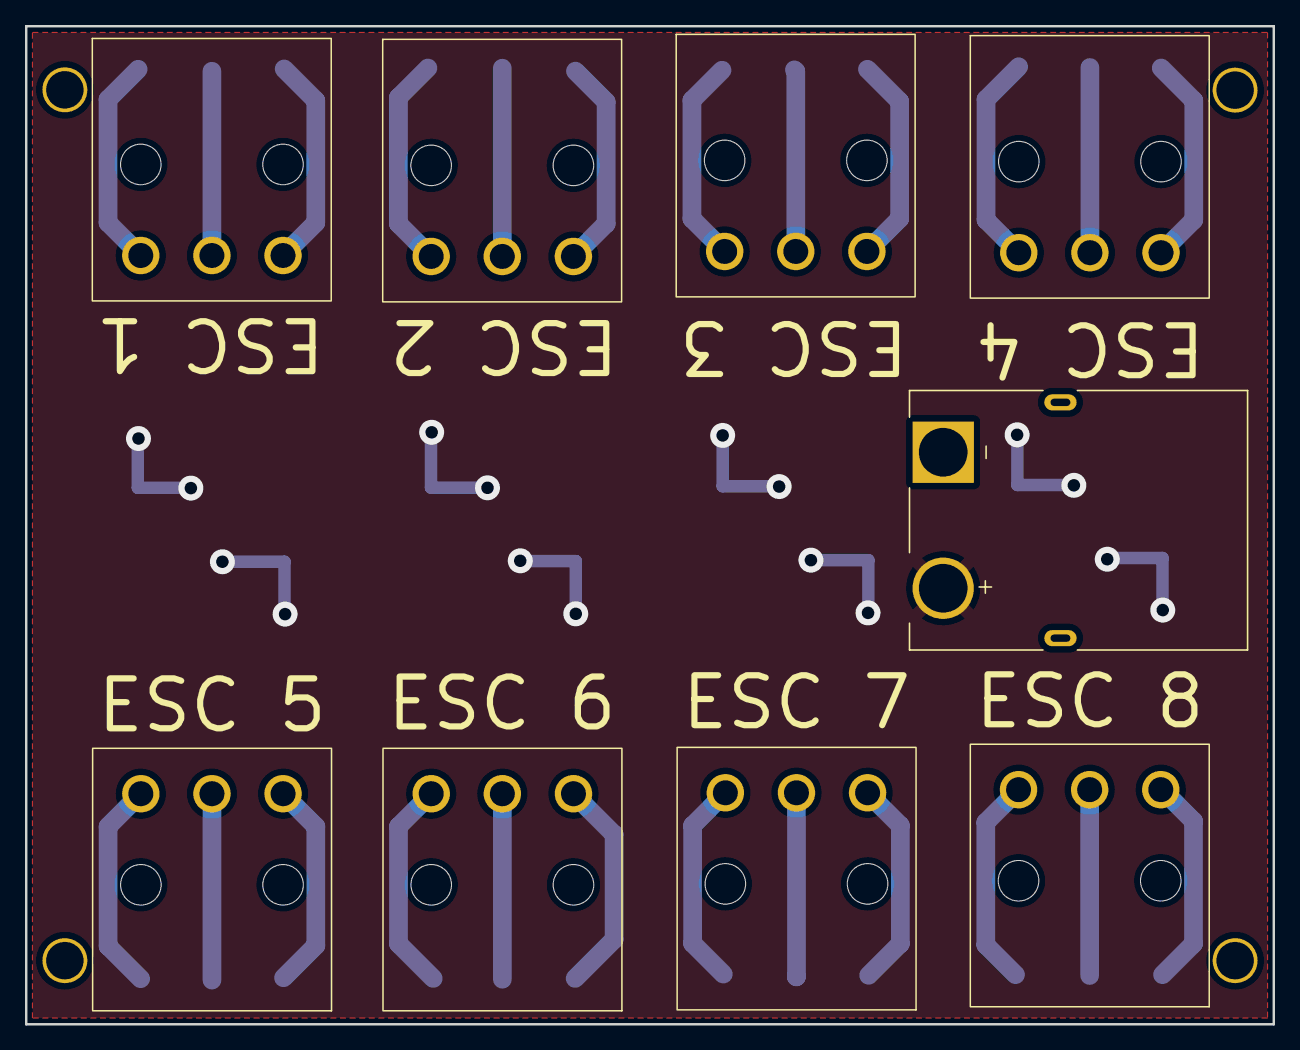
[picture p17: board esc.kicad_pcb from above]

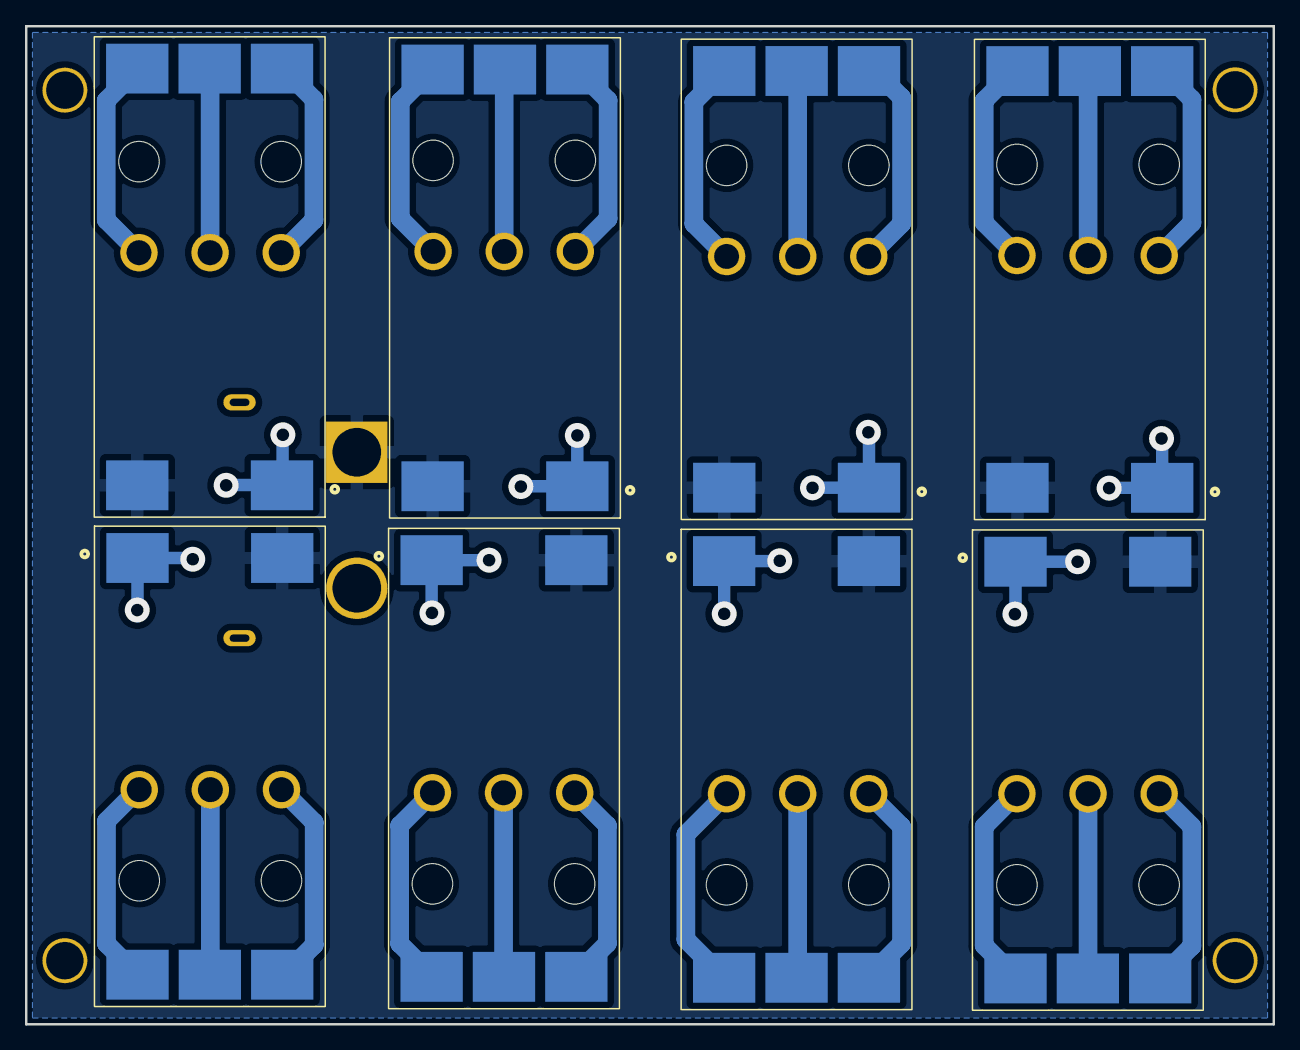
[picture p18: board esc.kicad_pcb from below]

Board: 2 copper layers, 100.0 x 80.0 mm, 21 parts (8 on the bottom side), 26 nets.
